dawe6/Faudraj/PMD85/pmd85-solder.jpg

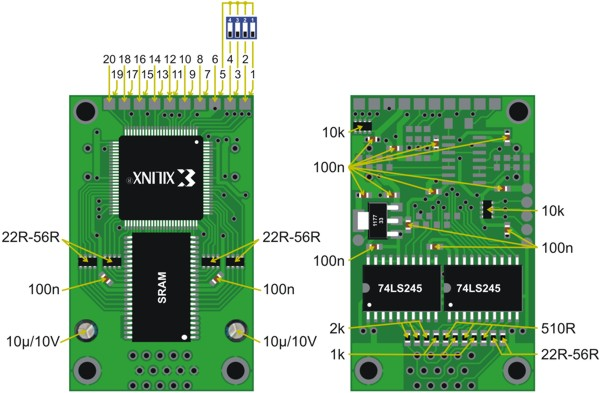
PMD85/pmd85-solder.jpg
