dawe6/Faudraj/ZXula1/ula1-solder.jpg

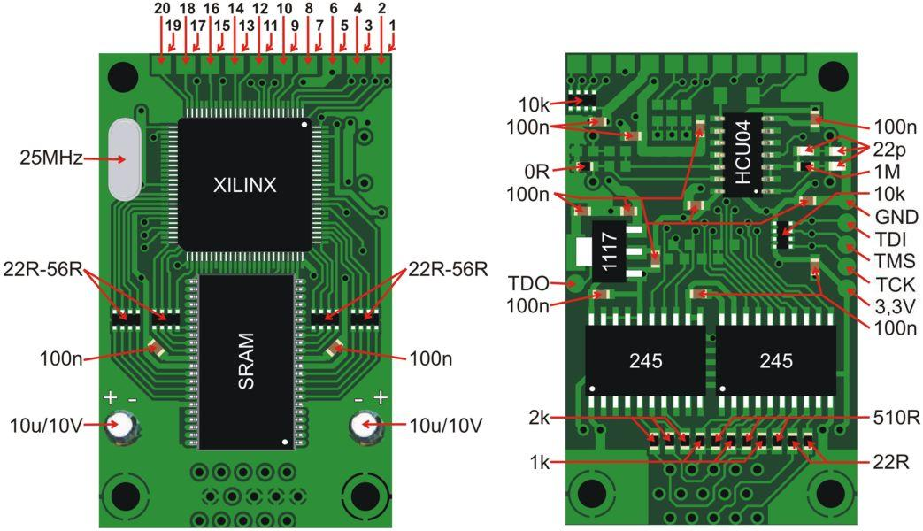
ZXula1/ula1-solder.jpg
