dawe6/Faudraj/ZXula48/ula48-description.txt

Omezeni:
--------
Zapojeni a test byl provaden pouze s pocitacem Didaktik Gama 89 s obvodem ULA 6C001E7.
Jiny pocitac a ani jiny obvod ULA nemam.
Pokud nekdo vyzkousite zapojeni s jinym typem pocitace nebo obvodem ULA dejte vedet vysledek ix9@atlas.cz.

Pripojovaci konektor:
---------------------
 1   nepouzito
 2   nepouzito
 3 - propojka1	> OFF(n.c.) - normal, ON(GND) - scanlines, vstup je osetreny odporem 10k na +5V
 4 - propojka2	> OFF(n.c.) - normal, ON(GND) - zastaveni vga obrazu, vstup je osetreny odporem 10k na +5V
 5 - GND	> zem		k propojkam
 6 - GND	> zem
 7 - +5V	> napajeni
 8 - DATA0	> obvod ULA48k pin 18, datova sbernice u obvodu ULA48
 9 - DATA1	> obvod ULA48k pin 21, datova sbernice u obvodu ULA48
10 - DATA2	> obvod ULA48k pin 22, datova sbernice u obvodu ULA48
11 - DATA3	> obvod ULA48k pin 25, datova sbernice u obvodu ULA48
12 - DATA4	> obvod ULA48k pin 27, datova sbernice u obvodu ULA48
13 - DATA5	> obvod ULA48k pin 29, datova sbernice u obvodu ULA48
14 - DATA6	> obvod ULA48k pin 30, datova sbernice u obvodu ULA48
15 - DATA7	> obvod ULA48k pin 31, datova sbernice u obvodu ULA48
16 - IOULA	> obvod ULA48k pin 33, signal I/O operace s ULA48
17 - WR		> obvod ULA48k pin 2, signal WR
18 - INTR	> obvod ULA48k pin 12, preruseni z obvodu ULA48
19 - CLK14	> obvod ULA48k pin 39, hodiny 14MHz, VYSTUP z konvertoru (viz Hodiny 14MHz)
20 - OINTR	> preruseni, OC VYSTUP z konvertoru (viz Preruseni)

Hodiny 14MHz:
-------------
Konvertor potrebuje hodiny z pocitace, ale vzhledem k zapojeni oscilatoru u
obvodu ULA48 bylo nutne zdroj hodin presunout na desku konvertoru. Je potreba
vypajet krystal 14MHz z desky pocitace a pripajet na volnou pozici do
konvertoru. O hodiny pro obvod ULA se pak stara vystup z konvertoru pin19.

Preruseni:
----------
Konvertor provadi obrazovou synchronizaci pomoci signalu INT, ktery generuje
obvod ULA. Pokud nepouzijete zadne pridavne zarizeni, ktere generuje take
signal INT mel by byt provoz bez problemu i s nezapojenym vystupem
z konvertoru pin 20.
Pokud ale takove zarizeni provozujete dochazelo by k synchronizaci i pri
preruseni od pridavneho zarizeni. V takovem pripade je nutne signal INT na
desce pocitace od obvodu ULA48 oddelit a vystup ULA pin 12 privest do
konvertoru na pin18 a vystup z konveroru pin 20 pripojit na oddeleny signal
INT smerem k CPU.
