dawe6/Faudraj/ZXplus3/plus3-description.txt

Pripojovaci konektor:
---------------------
 1 - propojka1	> OFF(n.c.) - normal, ON(GND) - zastaveni vga obrazu, vstup je osetreny odporem 10k na +5V
 2 - propojka2	> OFF(n.c.) - normal, ON(GND) - inverze barev, vstup je osetreny odporem 10k na +5V
 3 - propojka3	> viz tabulka Pouziti pridavne intenzity, vstup je osetreny odporem 10k na +5V
 4 - propojka4	> viz tabulka Pouziti pridavne intenzity, vstup je osetreny odporem 10k na +5V
 5 - GND	> zem		k propojkam
 6 - GND	> zem
 7 - +5V	> napajeni
 8 - RED	> obvod ULA40077 pin 38
 9 - GREEN	> obvod ULA40077 pin 39
10 - BLUE	> obvod ULA40077 pin 37
11 - BRIGHT	> obvod ULA40077 pin 42
12 - SYNC	> obvod ULA40077 pin 43
13   nepouzito
14   nepouzito
15   nepouzito
16   nepouzito
17 - CLK35	> obvod ULA40077 pin 100
18   nepouzito
19   nepouzito
20   nepouzito

Pouziti pridavne intenzity:
---------------------------
propojka3	propojka4	funkce
OFF(n.c.)	OFF(n.c.)	normal
ON(GND)		OFF(n.c.)	scanlines - kazdy sudy pulradek ma vyssi intenzitu, kazdy lichy ma potlacenou intenzitu
OFF(n.c.)	ON(GND)		pridavna intenzita se pouzije na vsechny barvy krome cerne, ktere nemaji vyssi intensitu		
ON(GND)		ON(GND)		pridavna intenzita se pouzije na vsechny barvy krome cerne
