dawe6/Faudraj/MZ800/mz800-description.jpg

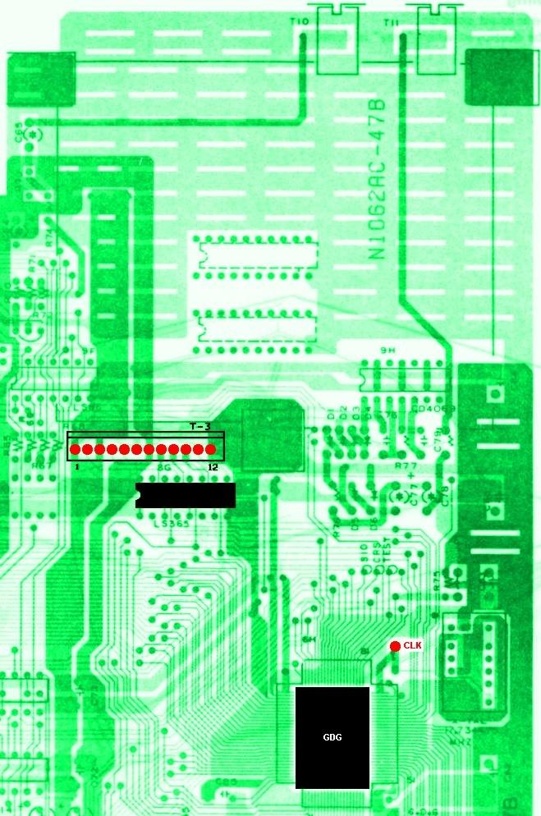
MZ800/mz800-description.jpg
