dawe6/Faudraj/ZXplus3/plus3-description.jpg

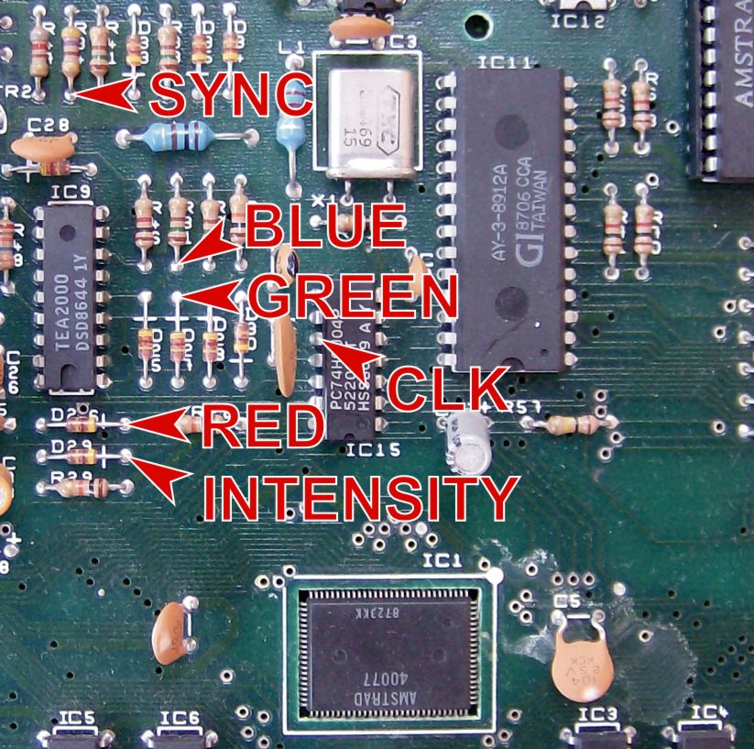
ZXplus3/plus3-description.jpg
