dawe6/Faudraj/pcb/V3.2/Faudraj.brd

## EAGLE design pcb/V3.2/Faudraj.brd (2022-12-05)

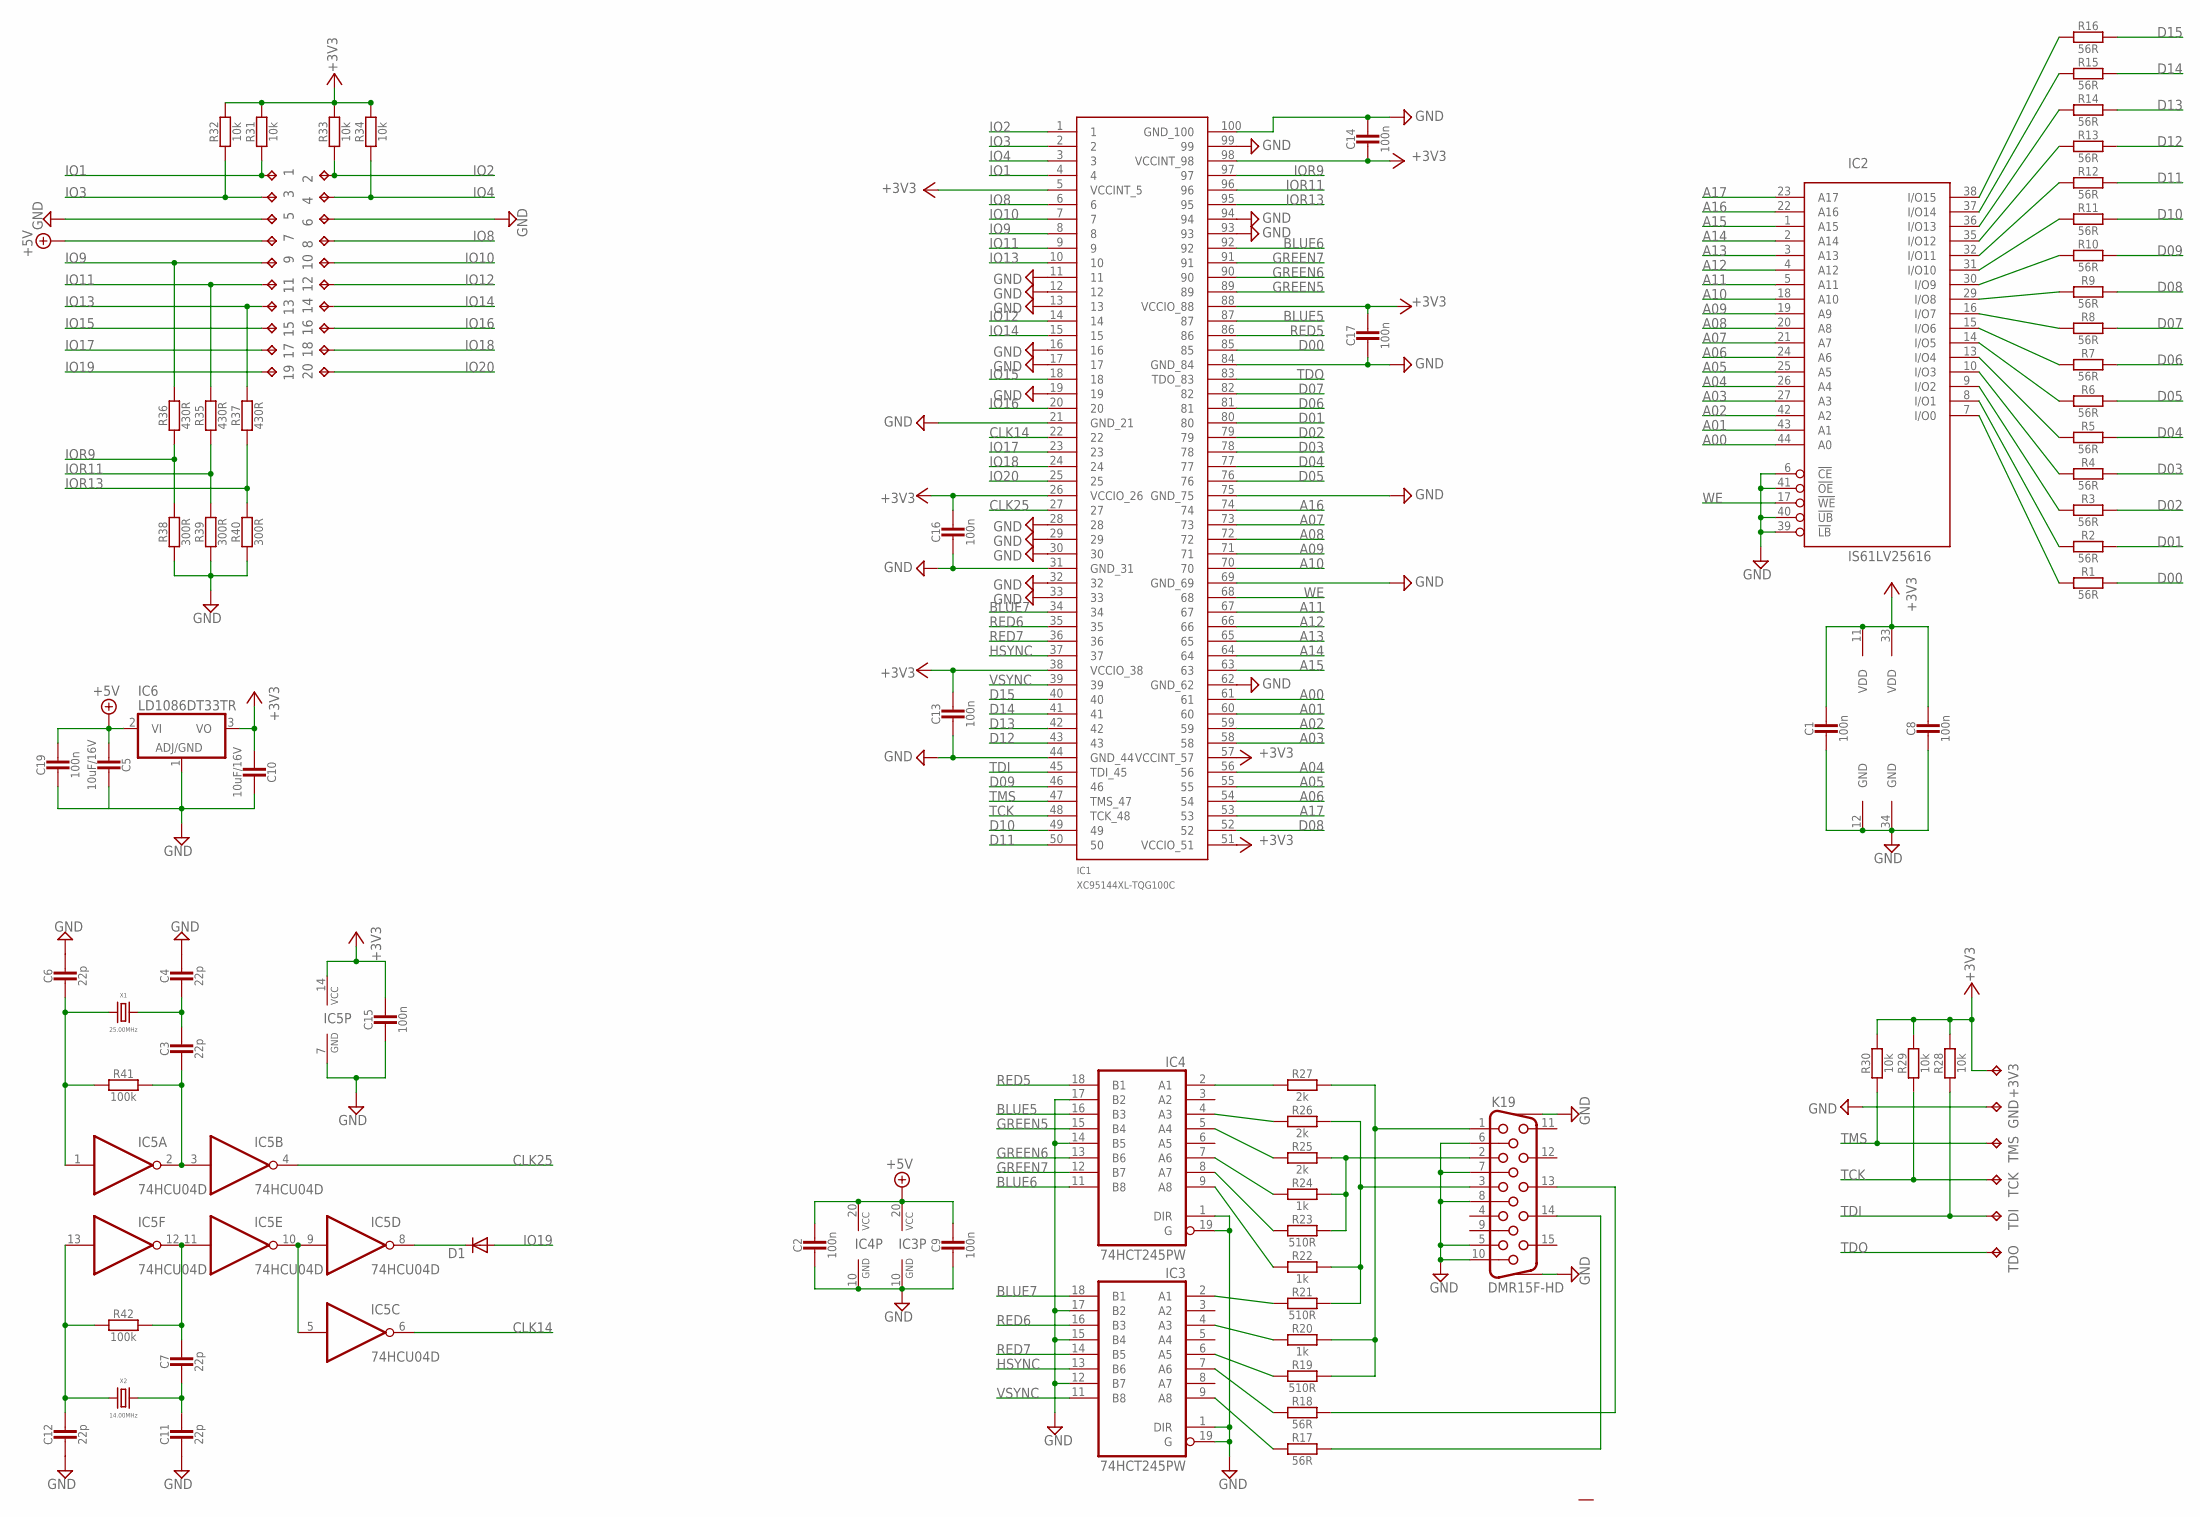
[picture p5: schematic Faudraj.sch]

Parts:
1, 2, 3, 4, 5, 6, 7, 8, 9, 10, 11, 12, 13, 14, 15, 16, 17, 18, 19, 20: nic; TP20R
+3V3: nic; TP20R
C1, C2, C8, C9, C13, C14, C15, C16, C17, C19: 100n; SMD0603
C3, C4, C6, C7, C11, C12: 22p; SMD0603
C5, C10: 10uF/16V; SMD1206
D1: DIODE-MINIMELF; MINIMELF
GND: nic; TP20R
IC1: XC95144XL-TQG100C; TQFP100
IC2: IS61LV25616; TSOP-II-44
IC3, IC4: 74HCT245PW; TSSOP20
IC5: 74HCU04D; SO14
IC6: LD1086DT33TR; TO252
K19: DMR15F-HD; HF15G
R1, R2, R3, R4, R5, R6, R7, R8, R9, R10, R11, R12, R13, R14, R15, R16, R17, R18: 56R; SMD0603
R19, R21, R23: 510R; SMD0603
R20, R22, R24: 1k; SMD0603
R25, R26, R27: 2k; SMD0603
R28, R29, R30, R31, R32, R33, R34: 10k; SMD0603
R35, R36, R37: 430R; SMD0603
R38, R39, R40: 300R; SMD0603
R41, R42: 100k; SMD0603
SJ1: nic; OTVOR3.2
TCK: nic; TP20R
TDI: nic; TP20R
TDO: nic; TP20R
TMS: nic; TP20R
X1: 25.00MHz; HC49U-V
X2: 14.00MHz; HC49U-V

Connections:
+3V3: +3V3.TP, C1.1, C8.1, C10.2, C13.1, C14.2, C15.1, C16.1, C17.1, IC1.5 (VCCINT_5), IC1.26 (VCCIO_26), IC1.38 (VCCIO_38), IC1.51 (VCCIO_51), IC1.57 (VCCINT_57), IC1.88 (VCCIO_88), IC1.98 (VCCINT_98), IC2.11 (VDD), IC2.33 (VDD), IC5.14 (VCC), IC6.3 (VO), R28.2, R29.2, R30.2, R31.2, R32.2, R33.2, R34.2
+5V: 7.TP, C2.1, C5.2, C9.1, C19.1, IC3.20 (VCC), IC4.20 (VCC), IC6.2 (VI)
A00: IC1.61, IC2.44 (A0)
A01: IC1.60, IC2.43 (A1)
A02: IC1.59, IC2.42 (A2)
A03: IC1.58, IC2.27 (A3)
A04: IC1.56, IC2.26 (A4)
A05: IC1.55, IC2.25 (A5)
A06: IC1.54, IC2.24 (A6)
A07: IC1.73, IC2.21 (A7)
A08: IC1.72, IC2.20 (A8)
A09: IC1.71, IC2.19 (A9)
A10: IC1.70, IC2.18 (A10)
A11: IC1.67, IC2.5 (A11)
A12: IC1.66, IC2.4 (A12)
A13: IC1.65, IC2.3 (A13)
A14: IC1.64, IC2.2 (A14)
A15: IC1.63, IC2.1 (A15)
A16: IC1.74, IC2.22 (A16)
A17: IC1.53, IC2.23 (A17)
B5: IC4.4 (A3), R26.1
B6: IC4.9 (A8), R22.1
B7: IC3.2 (A1), R21.1
BLUE5: IC1.87, IC4.16 (B3)
BLUE6: IC1.92, IC4.11 (B8)
BLUE7: IC1.34, IC3.18 (B1)
CLK14: IC1.22, IC5.6 (O)
CLK25: IC1.27, IC5.4 (O)
D00: IC1.85, R1.2
D01: IC1.80, R2.2
D02: IC1.79, R3.2
D03: IC1.78, R4.2
D04: IC1.77, R5.2
D05: IC1.76, R6.2
D06: IC1.81, R7.2
D07: IC1.82, R8.2
D08: IC1.52, R9.2
D09: IC1.46, R10.2
D10: IC1.49, R11.2
D11: IC1.50, R12.2
D12: IC1.43, R13.2
D13: IC1.42, R14.2
D14: IC1.41, R15.2
D15: IC1.40, R16.2
G5: IC4.5 (A4), R25.1
G6: IC4.7 (A6), R24.1
G7: IC4.8 (A7), R23.1
GND: 5.TP, 6.TP, C1.2, C2.2, C4.1, C5.1, C6.1, C8.2, C9.2, C10.1, C11.2, C12.2, C13.2, C14.1, C15.2, C16.2, C17.2, C19.2, GND.TP, IC1.11, IC1.12, IC1.13, IC1.16, IC1.17, IC1.19, IC1.21 (GND_21), IC1.28, IC1.29, IC1.30, IC1.31 (GND_31), IC1.32, IC1.33, IC1.44 (GND_44), IC1.62 (GND_62), IC1.69 (GND_69), IC1.75 (GND_75), IC1.84 (GND_84), IC1.93, IC1.94, IC1.99, IC1.100 (GND_100), IC2.6 (!CE), IC2.12 (GND), IC2.34 (GND), IC2.39 (!LB), IC2.40 (!UB), IC2.41 (!OE), IC3.1 (DIR), IC3.10 (GND), IC3.12 (B7), IC3.15 (B4), IC3.17 (B2), IC3.19 (G), IC4.1 (DIR), IC4.10 (GND), IC4.14 (B5), IC4.17 (B2), IC4.19 (G), IC5.7 (GND), IC6.1 (ADJ_GND), K19.5, K19.6, K19.7, K19.8, K19.10, K19.G1, K19.G2, R38.1, R39.1, R40.1
GREEN5: IC1.89, IC4.15 (B4)
GREEN6: IC1.90, IC4.13 (B6)
GREEN7: IC1.91, IC4.12 (B7)
HS: IC3.7 (A6), R18.1
HSYNC: IC1.37, IC3.13 (B6)
IO1: 1.TP, IC1.4, R31.1
IO2: 2.TP, IC1.1, R33.1
IO3: 3.TP, IC1.2, R32.1
IO4: 4.TP, IC1.3, R34.1
IO8: 8.TP, IC1.6
IO9: 9.TP, IC1.8, R36.2
IO10: 10.TP, IC1.7
IO11: 11.TP, IC1.9, R35.2
IO12: 12.TP, IC1.14
IO13: 13.TP, IC1.10, R37.2
IO14: 14.TP, IC1.15
IO15: 15.TP, IC1.18
IO16: 16.TP, IC1.20
IO17: 17.TP, IC1.23
IO18: 18.TP, IC1.24
IO19: 19.TP, D1.A
IO20: 20.TP, IC1.25
IOR9: IC1.97, R36.1, R38.2
IOR11: IC1.96, R35.1, R39.2
IOR13: IC1.95, R37.1, R40.2
unnamed: IC2.7 (I/O0), R1.1
unnamed: IC2.16 (I/O7), R8.1
unnamed: IC2.29 (I/O8), R9.1
unnamed: C6.2, IC5.1 (I), R41.1, X1.2
unnamed: C3.2, IC5.2 (O), IC5.3 (I), R41.2
unnamed: IC2.15 (I/O6), R7.1
unnamed: IC2.14 (I/O5), R6.1
unnamed: IC2.13 (I/O4), R5.1
unnamed: IC2.10 (I/O3), R4.1
unnamed: IC2.9 (I/O2), R3.1
unnamed: IC2.8 (I/O1), R2.1
unnamed: IC2.30 (I/O9), R10.1
unnamed: IC2.31 (I/O10), R11.1
unnamed: IC2.32 (I/O11), R12.1
unnamed: IC2.35 (I/O12), R13.1
unnamed: IC2.36 (I/O13), R14.1
unnamed: IC2.37 (I/O14), R15.1
unnamed: IC2.38 (I/O15), R16.1
unnamed: C3.1, C4.2, X1.1
unnamed: C7.1, IC5.11 (I), IC5.12 (O), R42.2
unnamed: IC5.5 (I), IC5.9 (I), IC5.10 (O)
unnamed: D1.C, IC5.8 (O)
unnamed: C12.1, IC5.13 (I), R42.1, X2.2
unnamed: C7.2, C11.1, X2.1
R5: IC4.2 (A1), R27.1
R6: IC3.4 (A3), R20.1
R7: IC3.6 (A5), R19.1
RED5: IC1.86, IC4.18 (B1)
RED6: IC1.35, IC3.16 (B3)
RED7: IC1.36, IC3.14 (B5)
TCK: IC1.48 (TCK_48), R29.1, TCK.TP
TDI: IC1.45 (TDI_45), R28.1, TDI.TP
TDO: IC1.83 (TDO_83), TDO.TP
TMS: IC1.47 (TMS_47), R30.1, TMS.TP
VGA_BLUE: K19.3, R21.2, R22.2, R26.2
VGA_GREEN: K19.2, R23.2, R24.2, R25.2
VGA_HSYNC: K19.13, R18.2
VGA_RED: K19.1, R19.2, R20.2, R27.2
VGA_VSYNC: K19.14, R17.2
VS: IC3.9 (A8), R17.1
VSYNC: IC1.39, IC3.11 (B8)
WE: IC1.68, IC2.17 (!WE)

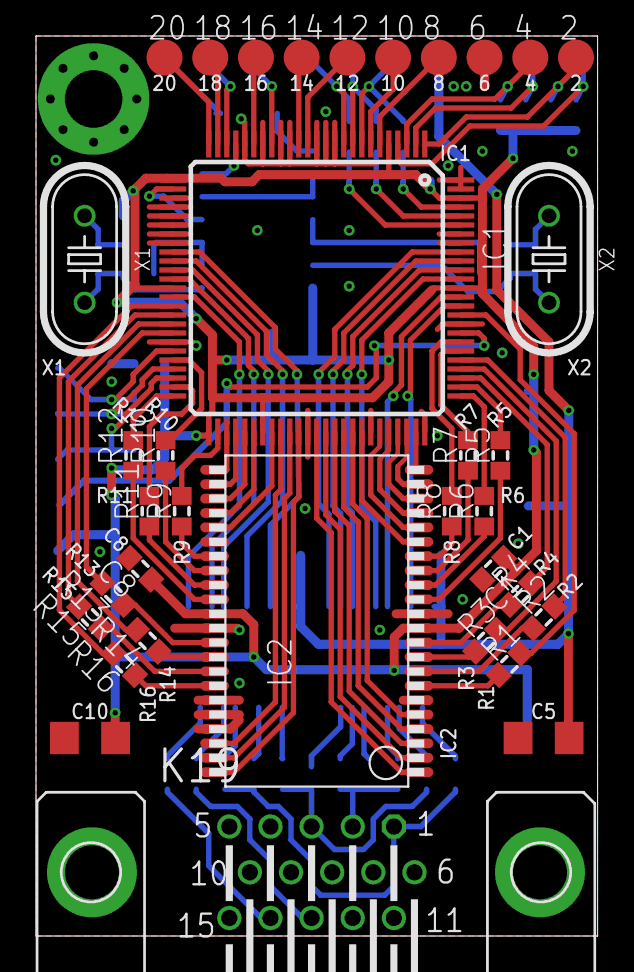
[picture p6: board Faudraj.brd from above]

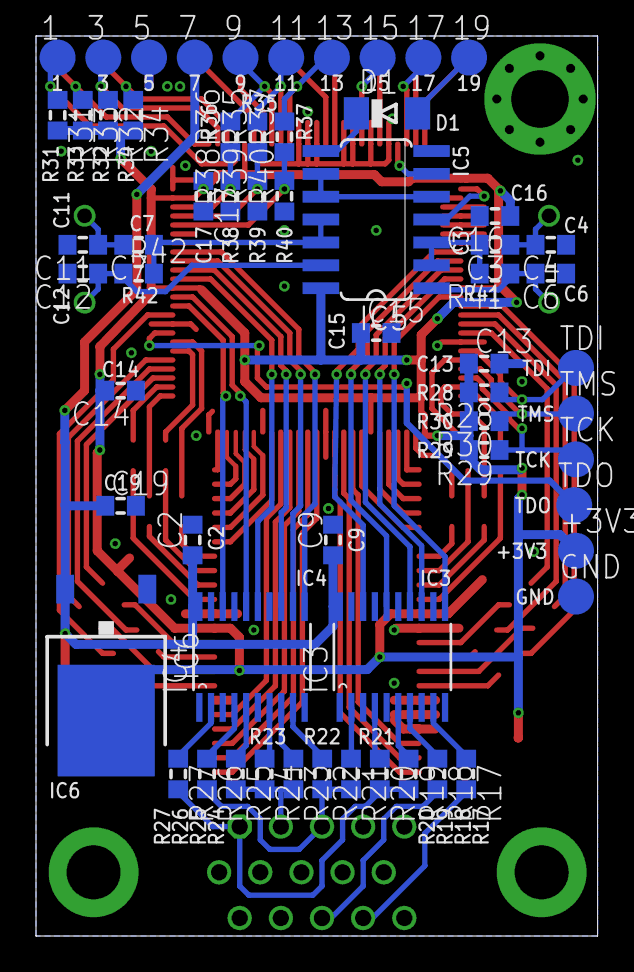
[picture p7: board Faudraj.brd from below]

Board: 2 copper layers, 31.2 x 50.0 mm, 97 parts (61 on the bottom side), 115 nets.
